jp112sdl/HB-UNI-Sen-TEMP-DS18B20/README.md

# HB-UNI-Sen-TEMP-DS18B20
## Funk "8fach Universal-Temperatursensor" für die Integration in HomeMatic

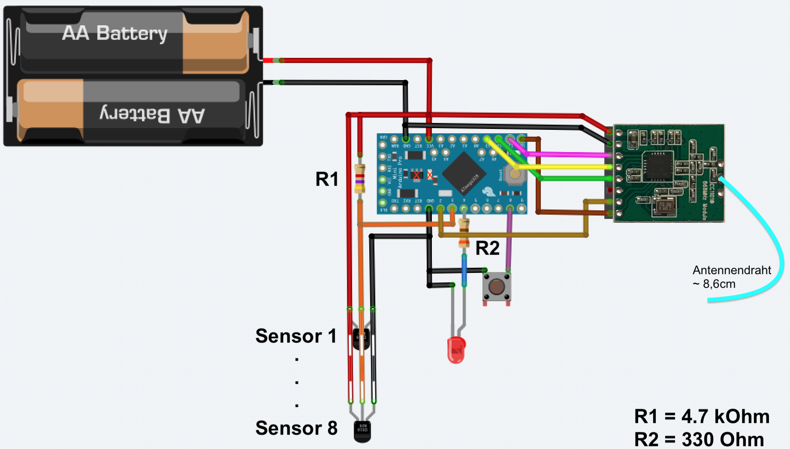
[picture p1: Images/wiring.png]
wiring


## benötigte Hardware
* 1x Arduino Pro Mini **ATmega328P (3.3V / 8MHz)**
* 1x CC1101 Funkmodul **(868 MHz)**
* 1x FTDI Adapter (wird nur zum Flashen benötigt)
* 1x Taster (beliebig... irgendwas, das beim Draufdrücken schließt :smiley:)
* 1x LED 
* 1x Widerstand 330 Ohm
* 1x Widerstand 4,7k (ausprobieren, teilweise wird bei langen Leitungen ein 2,2k Widerstand benötigt)
* 1x ... 8x DS18B20 Temperatursensor(en)
* Draht, um die Komponenten zu verbinden

Um die Batterielebensdauer zu erhöhen, ist es unbedingt notwendig, die grüne LED sowie den LDO vom Arduino Pro Mini (die 2 roten X auf dem Schaltplan) abzulöten, oder mit einem kleinen Schraubendreher oder Messer von der Platine zu entfernen. Unbedingt aufpassen, dass keine Leiterbahnen zerstört werden.

## Universalplatine
Wer eine eigene Platine herstellen möchte, kann auf eine Auswahl verschiedener vorgefertigter Layouts zurückgreifen.
z.B.:
- [PCB](https://github.com/alexreinert/PCB) von alexreinert
- [HMSensor](https://github.com/pa-pa/HMSensor) von pa-pa

## Code flashen
- [AskSinPP Library](https://github.com/pa-pa/AskSinPP) in der Arduino IDE installieren
  - Achtung: Die Lib benötigt selbst auch noch weitere Bibliotheken, siehe [README](https://github.com/pa-pa/AskSinPP#required-additional-arduino-libraries).
- [Projekt-Datei](https://raw.githubusercontent.com/jp112sdl/HB-UNI-Sen-TEMP-DS18B20/master/HB-UNI-Sen-TEMP-DS18B20.ino) herunterladen.
- Arduino IDE öffnen
  - Heruntergeladene Projekt-Datei öffnen
  - Werkzeuge
    - Board: Arduino Pro or Pro Mini
    - Prozessor: ATmega328P (3.3V 8MHz) 
    - Port: entsprechend FTDI Adapter
einstellen
- Menü "Sketch" -> "Hochladen" auswählen.

## Addon installieren
Um die Geräteunterstützung zu aktivieren, wird die aktuellste Version des [JP-HB-Devices Addon](https://github.com/jp112sdl/JP-HB-Devices-addon/releases/latest) benötigt!

## Gerät anlernen
Wenn alles korrekt verkabelt und das Addons installiert ist, kann das Gerät angelernt werden.<br>
Über den Button "Gerät anlernen" in der WebUI öffnet sich der Anlerndialog.<br>
Button "HM Gerät anlernen" startet den Anlernmodus.<br>
Nun ist der Taster (an Pin D8) kurz zu drücken.<br>
Die LED leuchtet für einen Moment.<br>
Anschließend ist das Gerät im Posteingang zu finden.<br>
Dort auf "Fertig" geklickt, wird es nun in der Geräteübersicht aufgeführt.<br>
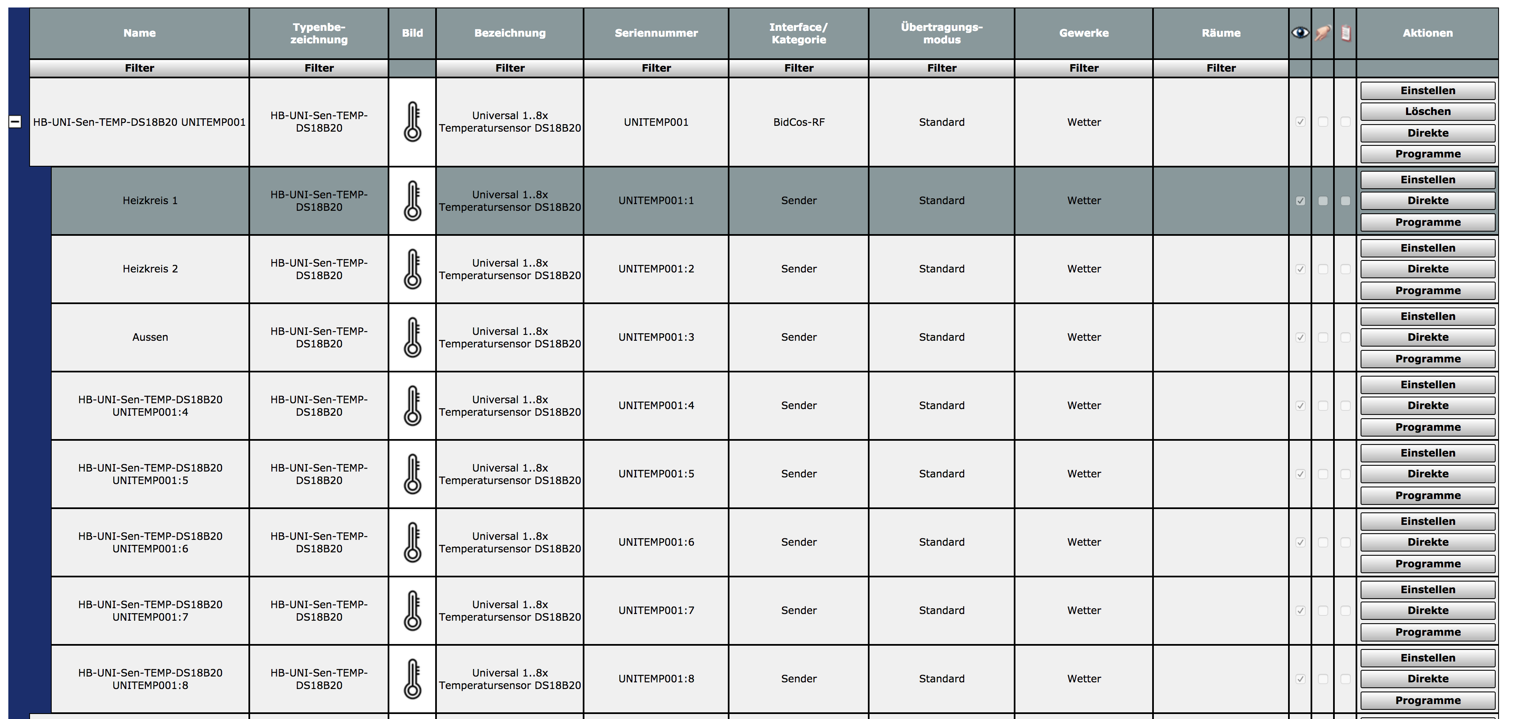
[picture p2: Images/ccu_geraete.png]

<br><br>
Das Sendeintervall kann zwischen 60 und 600 Sekunden eingestellt werden.<br>
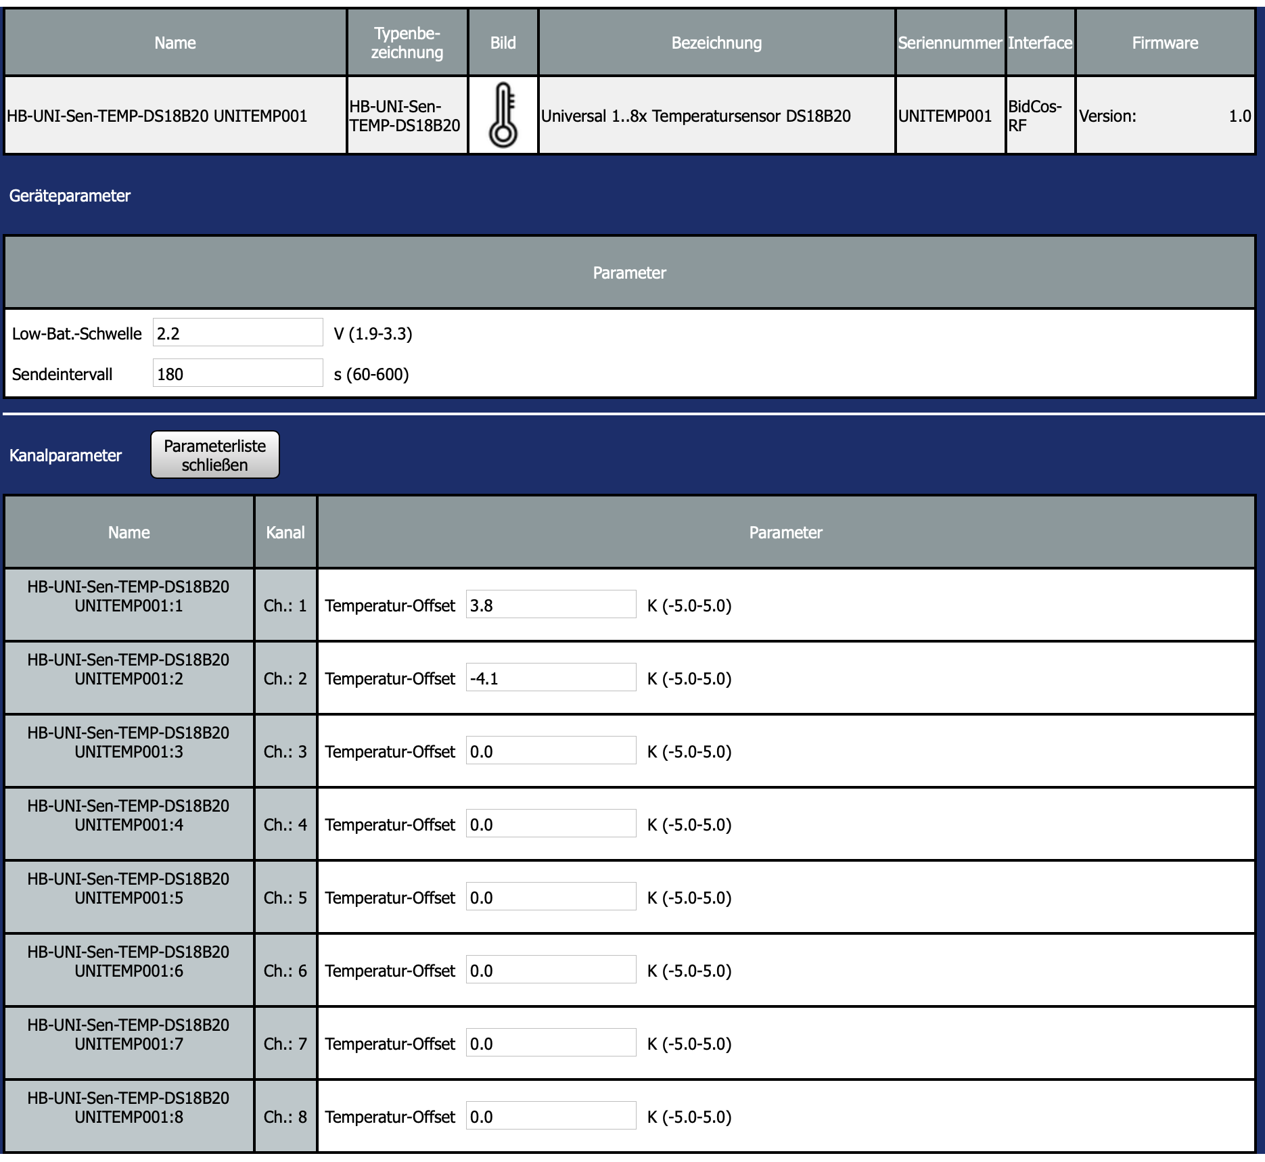
[picture p3: Images/ccu_einstellungen.png]

<br><br>
Unter "Status und Bedienung" -> "Geräte" können die einzelnen Werte angezeigt werden.<br>
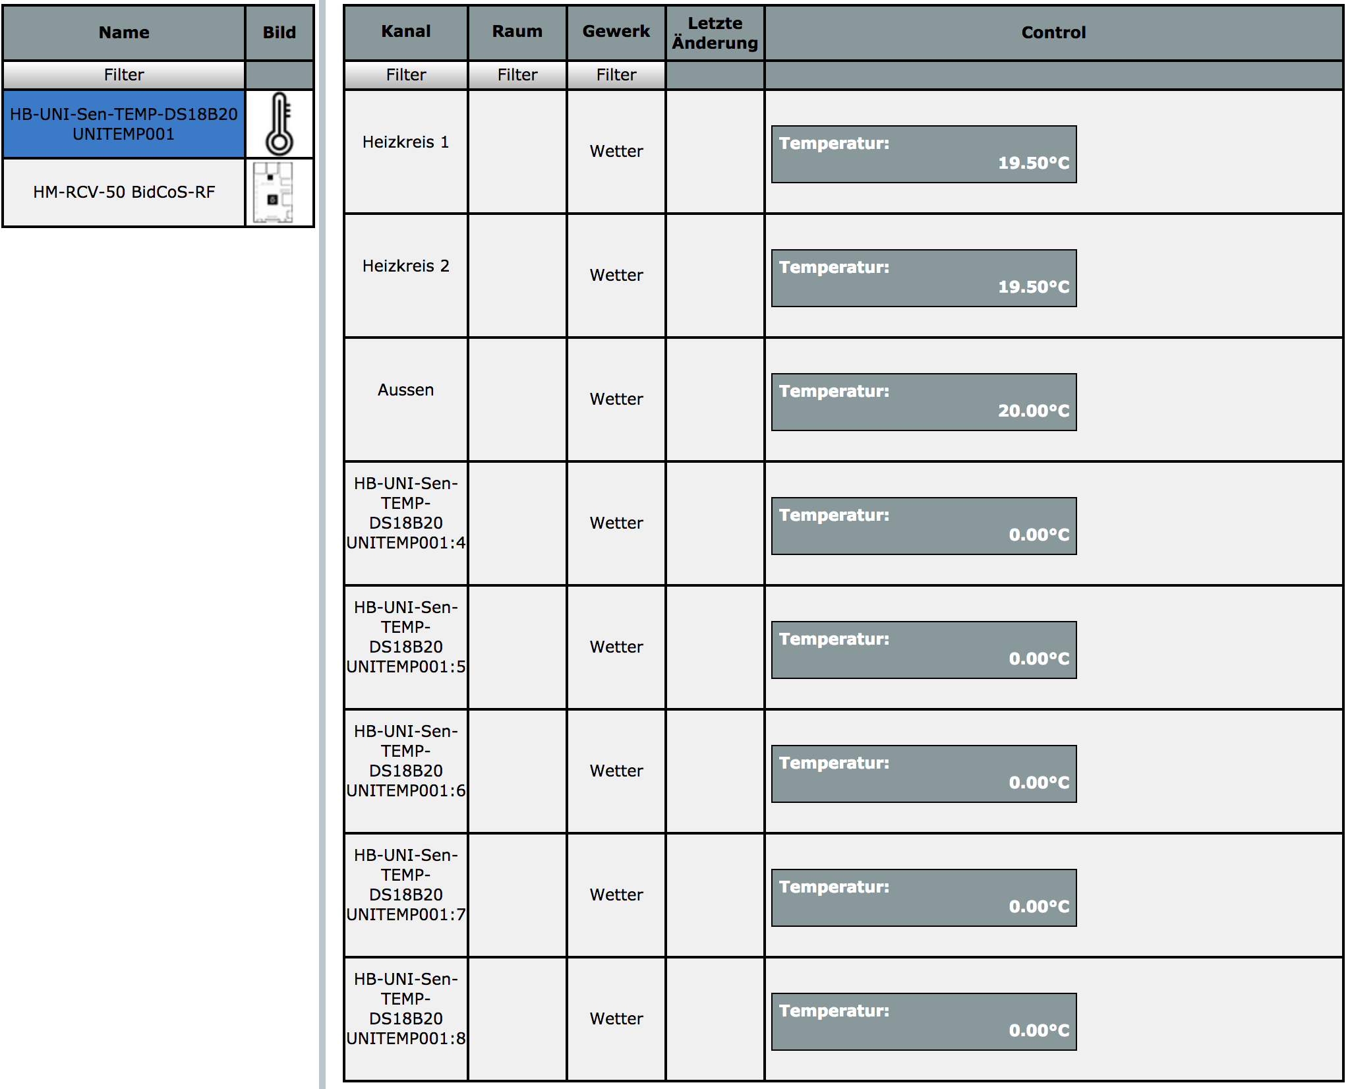
[picture p4: Images/ccu_status.png]


Eine Verwendung in Programmen ist ebenfalls möglich.

## LCD Display
Unterstützung von LCD 4x20 Zeichen LCD I2C Displays.<br>
Der Anschluss erfolgt über die Hardware-I2C Pins des Pro Mini (SDA=A4, SCL=A5).<br>
Im Sketch sind bei den Zeilen<br>
```
//#define USE_LCD
//#define LCD_ADDRESS 0x3f
```
die Kommentarzeichen `//` zu entfernen, sowie die `LCD_ADRESS` entsprechend anzupassen.
<br><br>

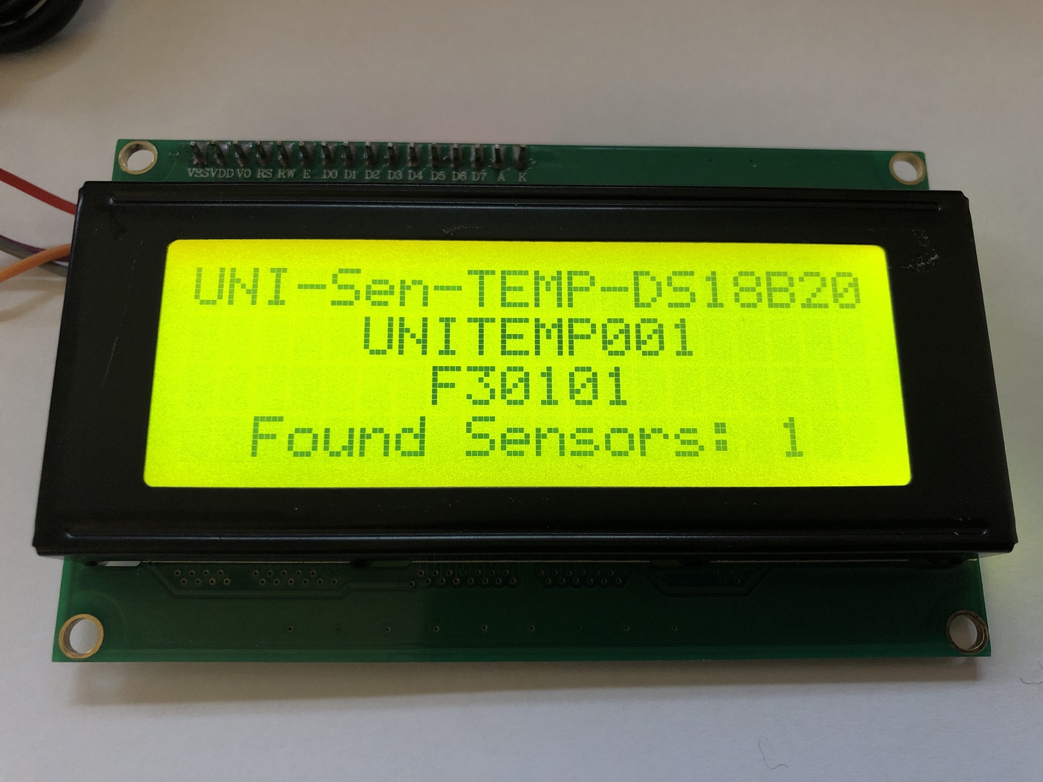
[picture p5: Images/LCD_Startscreen.jpeg]

<br>
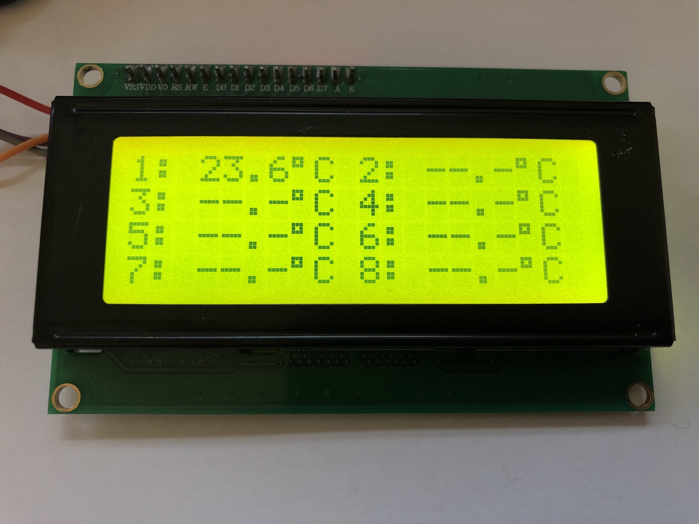
[picture p6: Images/LCD_Tempscreen.jpeg]
