jp112sdl/HB-UNI-Sen-TEMP-DS18B20/Images/ccu_addon.png

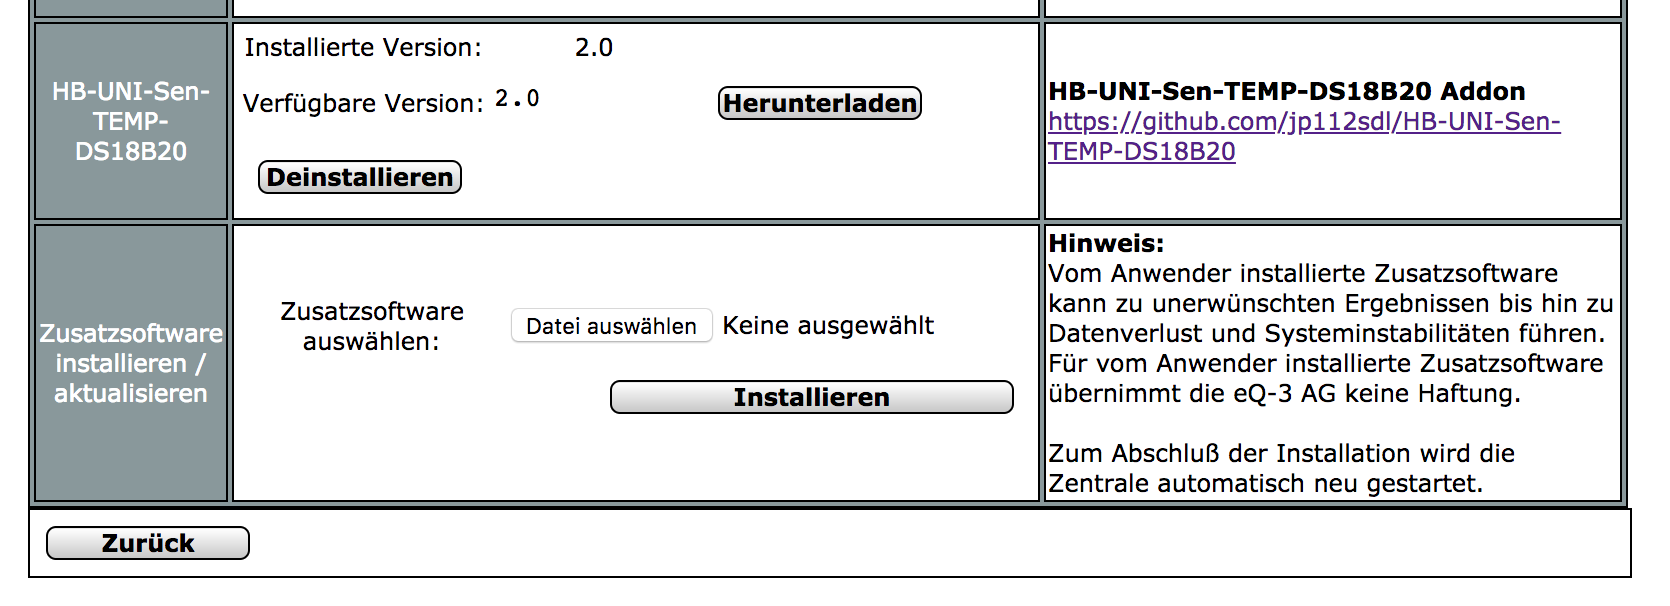
Images/ccu_addon.png
