jp112sdl/HB-UNI-Sen-TEMP-DS18B20/(list of files, drawings)

Other design files:
Images/wiring.fzz
