jp112sdl/HB-UNI-Sen-TEMP-DS18B20/(threads)

Thread 2 (2018-07-16):

HB-UNI-Sen-TEMP-DS18B20.ino

isolhara, 2018-07-16:
Es werden immer nur die ersten 4 Sensoren übertragen. Ich habe 5 Sensoren angeschlossen. Wenn ich bei der Aufteilung der Messages  '4' und dann '0' vertausche, wird nur Sensor 5 übertragen, 1 bis 4 nicht.

jp112sdl, 2018-07-16:
Werden im seriellen Monitor 5 Temperaturen angezeigt?
Ist die Zentrale eine CCU2 oder RaspberryMatic?

isolhara, 2018-07-16:
Wo finde ich den seriellen Monitor. Es ist mein erstes Arduino Projekt. Es handel sich um eine RaspberryMatic Zentrale.

jp112sdl, 2018-07-16:
https://learn.adafruit.com/adafruit-arduino-lesson-5-the-serial-monitor/the-serial-monitor

Unten rechts muss die Baudrate 57600 eingestellt werden.

isolhara, 2018-07-16:
Es kommen nur unlesbare Zeichen

jp112sdl, 2018-07-16:
Und wenn du auf 115200 stellst?

jp112sdl, 2018-07-16:
Ich habe schon eine Vermutung...
Kann es sein, dass du eine 16MHz Arduino nutzt?

isolhara, 2018-07-16:
Ich hatte keinen Zugriff mehr auf GitHub

jp112sdl, 2018-07-16:
Ja, Github war vorhin down.

Hast du vor dem Flashen auf 8MHz gestellt?
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

jp112sdl, 2018-07-16:
Ok - also zusammengefasst:
**8Mhz** eingestellt - seriell kommen Meldungen nur bei **115200 Baud**
In der Lib sind **57600 Baud** vorgegeben - heißt -> **du hast einen 16MHz Arduino Pro Mini**.

Die Lib ist jedoch von den Timings her auf 8MHz ausgelegt.
Da der 16MHz-Arduino nun alles doppelt so schnell rechnet, wirst du das nicht sauber zum Laufen bekommen.

Daher auch der Hinweis in der README fettgedruckt: **ATmega328P (3.3V / 8MHz)**

Du kannst versuchen, das delay zwischen den beiden Telegrammen zu verdoppeln.
[HB-UNI-Sen-TEMP-DS18B20.ino#L145](https://github.com/jp112sdl/HB-UNI-Sen-TEMP-DS18B20/blob/7b6502f7c7ed16385bb2d235ee7eceb012a968a0/HB-UNI-Sen-TEMP-DS18B20/HB-UNI-Sen-TEMP-DS18B20.ino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)
`_delay_ms(200);` -> `_delay_ms(400);`

jp112sdl, 2018-07-16:
Ich rate beim 16MHz Pro Mini auch dringend von Batteriebetrieb ab!

isolhara, 2018-07-16:
Ok, besten Dank. Ich habe zwei Arduino 3,3V 8 MHz bei EBay (China) gekauft. Versuche nun einen wirklichen 3,3V 8MHz zu bekommen, leider ist es auf dem Arduino selbst nicht zu sehen. Ich habe bereits ein Spannungsreglermodul 3,3 V ausprobiert.

jp112sdl, 2018-07-16:
Auf dem Oszillator steht beim 8MHz Pro Mini eine **80** oder **08** (je nachdem wie rum man drauf schaut):
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

Bei dem 16MHz Modell steht da glaub ich **A0**.

Das Problem ist, dass der 328P bei 16MHz mind. 4,3V benötigt, um stabil zu laufen.

isolhara, 2018-07-16:
Das delay hatte ich schon mal auf 500 ms gesetzt, hatte nichts gebracht. Für mich nicht erklärlich, wenn ich zuerst 5 - 8  in meinem Fall den Sensor 5 sende, dann die Sensoren 1 - 4 nicht mehr gesendet werden. Folglich müsste doch die Übertragung als solches funktionieren.

jp112sdl, 2018-07-16:
Schick mal die Logmeldungen vom Einschalten bis zur Übertragung der 2 Telegramme...

isolhara, 2018-07-16:
Wo finde ich diese Logmeldungen?

jp112sdl, 2018-07-16:
...immer noch im seriellen Monitor

isolhara, 2018-07-16:
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

isolhara, 2018-07-16:
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

jp112sdl, 2018-07-16:
Also zunächst mal ist das Device nicht korrekt angelernt.
Bitte noch mal löschen und neu anlernen.

Und ändere mal das delay auf 300.

jp112sdl, 2018-07-16:
Bei `F30101 000000` muss dort statt der `000000` die ID von der CCU drinstehen.

isolhara, 2018-07-16:
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

isolhara, 2018-07-16:
Neu angelernt habe vorher nochmals geändert, dass zuerst 5-8 und dann 1-4 übertragen wird.

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

jp112sdl, 2018-07-16:
Das sieht schon mal gut aus.
Aber du hast wieder die Telegramme umgedreht 😉
Zuerst 5-8, dann 1-4

jp112sdl, 2018-07-16:
Aber warum das in der WebUI nicht ankommt... ich kann mir da nur noch vorstellen, dass es am Timing liegt und dem 16MHz Pro Mini.
Bisher hat noch niemand einen solchen Fehler gemeldet

isolhara, 2018-07-16:
Gibt es die Möglichkeit, das im WebUI zu protokollieren?

jp112sdl, 2018-07-16:
Ich weiß nicht... Kannst ja mal das Gerät auf "Protokolliert" stellen.
Man könnte noch die Meldung vom `rfd` aber das führt hier alles zu weit.
Ich würde auch ungern noch weiter dran rumexperimentieren wollen, so lange nicht die Hardware eingesetzt wird, die offiziell unterstützt wird.
Tritt der Fehler mit einem echten 8MHz Pro Mini auf, können wir uns noch mal damit beschäftigen.
Ich kennen zumindest 2 weitere Leute, die die Schaltung mit 8 Sensoren erfolgreich im Einsatz haben.

Als letzten Versuch - statt das Delay zu erhöhen, setz es mal etwas herunter auf `100`.

isolhara, 2018-07-16:
Ok, ja das war wirklich eine großartige Unterstützung. Ich besorge mir einen 8 MHz und gebe dann eine Rückmeldung.
Guten Abend

jp112sdl, 2018-07-16:
Aber teste das mit den 100ms Delay trotzdem noch. Vielleicht gehts ja 👍
Viel Erfolg weiterhin

isolhara, 2018-07-16:
100 ms geht auch nicht, andere Arduino bereits bestellt.
Nochmals Danke.

jp112sdl, 2018-07-19:
RaspberryMatic nochmals neustarten

isolhara, 2018-07-19:
Danke das war's. Ich hatte auch schon RaspberryMatic neu gestartet, dann aber immer versucht das Gerät neu anzulernen. Jetzt habe ich einfach gewartet.
Auf dem alten Arduino steht auf dem Quarz keine Frequenzangabe. Die neuen sind richtig beschriftet.
Nochmals besten Dank für die Hilfe.

Closed 2018-07-19.

Thread 4 (2018-10-20):

One-Wire Pull Up Widerstand

spaceduck518, 2018-10-20:
Ich habe 8 Sensoren über ca. 10m Kabel angeschlossen und musste den Pullup von 4,7k auf 2,2k ändern um ein stabiles reading zu bekommen. Vermutlich würden auch 3,3k gehen, aber 4,7k scheint bei langen Leitungen grenzwertig zu sein.

jp112sdl, 2018-10-20:
Bei Wiki steht auch was von 2,2k
https://de.wikipedia.org/wiki/1-Wire#Elektrische_Eigenschaften

jp112sdl, 2018-10-20:
Habs in der Teileliste der README geändert.
Danke!

Closed 2018-10-20.

Thread 5 (2018-10-24):

AVR Fuse Settings

spaceduck518, 2018-10-24:
Müssen eigentlich im AVR die Fuses modifiziert werden, hier speziell für Batteriebetrieb die Brown Out Detection auf 1,8V oder gleich auf "OFF"?

spaceduck518, 2018-10-24:
Ok, Danke!

Closed 2018-10-24.

Thread 7 (2018-12-25):

Nach "Found x DS18B20 Sensor" keine Aktion mehr

Fiiti, 2018-12-25:
Hi,
bei mir bleibt nach dieser Ausgabe alles stehen:

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

Es passiert auch nichts, wenn ich auf den Button zum Anlernen drücke.

Zum Testen der Hardware hatte ich den Sketch https://github.com/jp112sdl/Beispiel_AskSinPP/tree/master/examples/HM-WDS40-TH-I-BME280 erfolgreich verwenden können. Natürlich auch mit entsprechenden anderem Sensor.
Lief erfolgreich mit der CCU3.

Ich nutze18b20 Sensoren, der Serielle Monitor zeigt auch die richtige Anzahl an. Bei einem 1, bei 2 zwei, usw.

Habe alle Leiterbahnen nachgemessen, auf kurzschlüsse untersucht usw.
Irgendeine Idee, wo ich noch schauen könnte?

Viele Grüße,
Fi

Fiiti, 2018-12-25:
Wenn ich den Sketch HM-WDS40-TH-I-DS18B20 mit den gleichen Sensoren nehme, dann kommt erfolgreich diese Ausgabe:
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

Hier wird der #include <DallasTemperature.h> verwendet - in Deinem nicht. Sondern anscheinend der #include <sensors/Ds18b20.h>
Mal schauen ob ich hier was finde.

jp112sdl, 2018-12-25:
Hi,

ich kanns leider auch auch nicht nachvollziehen.

Nach dem
`Found 2 DS18B20 Sensors`
kommt auch eigentlich nichts weiter.
Es wird die sysclock aktiviert, die 5 Sekunden später den Alarm im `sensarry` triggert.

Du kannst dir hilfweise mal noch eine Debugausgabe vor der Messung einbauen, um zu schauen, ob es wirklich was mit der Ds18b20.h zu tun hat.
z.B. [hier](https://github.com/jp112sdl/HB-UNI-Sen-TEMP-DS18B20/blob/master/HB-UNI-Sen-TEMP-DS18B20/HB-UNI-Sen-TEMP-DS18B20.ino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) noch ein `DPRINTLN("jetzt wird gemessen...");`.

Fiiti, 2018-12-26:
Danke.
Es blieb in der LCD Ausgabe stehen - obwohl diese nicht definiert war.
Ich habe dann schlussendlich alles gleöscht, neu kopiert, neu angelegt und alles lief sofort. Ob es nun der Kompiler, IDE oder ein Level 8 Problem war, werde ich nicht herausfinden.
Gute Arbeit - danke dafür!

Issue kann geschlossen werden.

jp112sdl, 2018-12-26:
Alles klar 👍
Es funktioniert nun also mit dem Code ausm Github 1:1, oder hast du noch was angepasst?

Fiiti, 2018-12-26:
Genau. Ich folgte dem Link von dir in deiner ersten Antwort. Habe dann RAW Ansicht ausgewählt.
Da habe ich den Code 1:1 kopiert und in der arduino IDE eingefügt. Kompiliert , hochgeladen und es lief sofort.
Den ersten Code habe ich irgendwie durch einen kompletten Download geholt bin git geholt.
Da bin ich über Links von technikkram gekommen.
Vielleicht ist auch hier der Fehler?

Egal, dein Code Funktioniert super und ich bin schwer begeistert.

Einzig würde ich mir wünschen, dass wenn weitere Sensoren angeschlossen werden, was ja problemlos im laufenden Betrieb ohne Reset bestens funktioniert, die bereits vorhandenen an der Position bleiben, wo sie waren.
Bsp: Hatte nur einen Sensor dann, in Ccu war dieser auf Position 1.
Jetzt steckte ich einen weiteren ran, und schwupps war der Alte auf Position 2 in der Ccu gerutscht. Der neue ist nun auf Platz 1.
Aber das ist jammern auf hohem Niveau. Kann mir nur vorstellen, dass bei einigen zu Problemen führen kann, wenn z.b. Programme diese Sensoren nutzen.
Man merkt es ja nicht gleich bei ähnlichen Produkten.

jp112sdl, 2018-12-26:
Es gab in der Richtung schon mal einen Ansatz von einem anderen Anwender.
Ich habe es aber nicht weiter verfolgt, da ich es eher so sehe, dass man ja ein Projekt mit x Sensoren umsetzt, dieses fertig baut und dann anlernt.
Da ändert sich dann nix mehr.
Ggf. könnte man noch die I2C-Adressen seriell ausgeben, so dass man im seriellen Monitor sehen kann, an welcher Position welcher Sensor erkannt wird und um dann bei Verschiebungen unkomplizierter reagieren zu können.

Fiiti, 2018-12-27:
Das ist eine gute Idee, werde ich vielleicht mal umsetzen, kann es ja pullen/pushen oder was auch immer, komme immer noch etwas mit Git durcheinander :-)
Soll ich schließen oder möchtest Du? Das scheint ein jeder auf Git anders handhaben zu wollen.

jp112sdl, 2018-12-27:
Das ist mir egal... Wenn gelöst, dann gelöst 👍
Und zu... 😃

Closed 2018-12-27.
