jp112sdl/HB-UNI-Sen-TEMP-DS18B20/(commit log)

2018-03-07 changed battery low and critical values
2018-03-07 added images
    [wiring.fzz]
2018-03-08 reworked device config
2018-03-09 fixed battery measurement
2018-03-10 compatible to sensors/Ds18b20.h included in AskSinPP Library
2018-03-12 completely reworked version 2 using single channels for each sensor
    [HB-UNI-Sen-TEMP-DS18B20.ino]
2018-03-22 deactivate if battery is critical
2018-03-23 making everything more reusable added uninstall routine to remove added values in webui.js und DEVDB.tcl
2018-03-29 debug: output temperatures
2018-03-31 - fixed wrong device image thumbnail file name in uninstall script
2018-05-14 replaced static value with define
    [HB-UNI-Sen-TEMP-DS18B20.ino]
2018-05-16 added support for dynamic channel creation in blocks of four temperature sensor channels
2018-05-16 Revert "added support for dynamic channel creation in blocks of four temperature sensor channels"
    This reverts commit 8f6b72a6af80073ad8ed982312ef0d6a5a369271.
    [HB-UNI-Sen-TEMP-DS18B20.ino]
2018-12-17 use correct LED_PIN define
    [HB-UNI-Sen-TEMP-DS18B20.ino]
2018-12-18 print temperatures on 4x20 lcd display
